SatoshiHatori/rgb_led_controller/docs/requirements.md

# 要求一覧

RGB LED Controller の要求と現在の状態を管理する。最終更新: 2026-11-08

## 運用ルール

- 要求を追加するときは、次の空き番号で行を足す。番号は再利用しない。
- 取り下げた要求や置き換えた要求は消さず、状態を「置換」にして置換先を書く。
- 状態を「完了」にするのは、根拠欄に確認方法を書けるときだけにする。
- 設計上の前提 (`ASM-`) は、確認が取れたら「確認済」にする。要求に昇格する場合は `REQ-` を追加する。

| 状態 | 意味 |
|---|---|
| 完了 | 確認済み |
| 設計完了 | 図面と検証ツールで確認済み。実機は未確認 |
| 進行中 | 一部できているが、満たしていない |
| 置換 | 別の要求に置き換えた |

## 要約

| 状態 | 件数 |
|---|---|
| 完了 | 13 |
| 設計完了 | 13 |
| 進行中 | 4 |
| 置換 | 3 |

## 要求 (REQ)

原文は依頼時の言葉のまま。

| ID | 要求 (原文) | 状態 | 現状と根拠 |
|---|---|---|---|
| REQ-001 | XIAO-RA4M1 を使う | 置換 | REQ-013 で CH32V203K8T6 に置き換え |
| REQ-002 | R/G/B/24V の LED テープを駆動する | 設計完了 | Q2〜Q4、J2。ERC/DRC 違反 0 |
| REQ-003 | 24V からマイコン電源を作る | 設計完了 | Q5 → U4 (5V) → U5 (3.3V)。ERC/DRC 違反 0 |
| REQ-004 | 回路を KiCad で設計する | 完了 | ERC 違反 0 (警告を含む)。A3 に 6 ブロックで配置し、文字とシンボルの重なりを解消 (OPEN-002) |
| REQ-005 | 基板設計する | 完了 | 51 × 42.6mm、2 層。配線済み、DRC 違反 0、未接続 0、回路図との不一致 0 |
| REQ-006 | 3D ビューを出す | 完了 | `hardware/docs/3d_*.png` |
| REQ-007 | 回路図やアートワークなどを README に書く | 完了 | `README.md` に掲載 |
| REQ-008 | 回路の基板設計は別ディレクトリに置く | 完了 | `hardware/` |
| REQ-009 | CAN からの信号で色を変えられるようにする | 設計完了 | 回路とファーム作成済み。PC テスト通過。実機は未確認 |
| REQ-010 | 基板外形はなるべく小さくする | 進行中 | 51 × 42.6mm。Rev A の 115 × 80mm より大幅に小さいが、ロック付き端子と 4 点固定を優先して仮配置の 38 × 31mm より大きくなった (ADR-0004) |
| REQ-011 | 部品は秋月電子通商など日本から購入しやすいものにする | 置換 | REQ-029 で基板の部品は LCSC 品に置き換え (ADR-0007)。電線側の部品は秋月 (`harness_parts.csv`) |
| REQ-012 | 単価を落とす | 進行中 | JLCPCB の実装込みで 5 枚 約 $97 (部品 $31.9、拡張部品の追加料金 $49.1、基本料など $15.8)。基板代と送料は別 (2026-11-07 時点)。追加料金が最大の費目 |
| REQ-013 | 制御マイコンを最小限の安いものにリプレースする | 完了 | CH32V203K8T6 (ADR-0001) |
| REQ-014 | 決定は ADR で記録する | 完了 | `docs/adr/` に 8 本 |
| REQ-015 | PlatformIO から書き込めるようにする (依頼時は質問「platformioから書き込める？」) | 進行中 | `firmware/platformio.ini` はあるが、PlatformIO でのビルドと書き込みは未実行。`make` でのクロスビルドは通過 (1,060 バイト、esp-13.2.0 の riscv32 gcc) |
| REQ-016 | コネクタも小さくする | 置換 | REQ-021 を優先。5A とロックを両立できる小型品がなく、CAN のみ小型の PA にした (ADR-0004) |
| REQ-017 | README の画像なども更新する | 完了 | 最終の基板データから再出力 |
| REQ-018 | 要求をリスト化して管理する | 完了 | この文書 |
| REQ-019 | 3D モデルがないものを作って追加する | 完了 | Q1〜Q4、F1、J1〜J3 を簡易形状で作成。J1〜J3 の寸法と高さは JST カタログ値 (OPEN-005)。JP1 は部品なし |
| REQ-020 | アートワークも設計して発注できる状態まで行く | 設計完了 | ガーバー、ドリル、BOM、座標を出力。JLCPCB の製造能力値でのルールチェックは違反 0。製造元ビューアでの確認と発注は未実施 (OPEN-003) |
| REQ-021 | 移動ロボットで使う。ネジ留めは抜けるので端子を見直す | 設計完了 | J1、J2 を JST VH、J3 を JST PA に変更 (ADR-0004)。実機の振動試験は未実施 |
| REQ-022 | 旧版は消してよい | 完了 | `archive/` を削除 |
| REQ-023 | 取付穴を 4 点固定にする | 完了 | H1〜H4 (M3) を四隅に配置。DRC 違反 0 |
| REQ-024 | モータ駆動回路とは別電源 | 設計完了 | TVS を SMBJ45CA に変更 (ADR-0006)。DRC 違反 0 |
| REQ-025 | CAN 途絶時は消灯する | 設計完了 | 既定 500ms で消灯 (ADR-0005)。PC テスト通過。実機は未確認 |
| REQ-026 | 電源の最大電圧は DC/DC コンバータの 24V 出力 | 設計完了 | 回路の許容範囲 約 13〜45V に収まるので回路変更なし。実機は未確認 |
| REQ-027 | CAN は優先度低めにする (ID の優先度と解釈) | 設計完了 | 既定 ID を 0x100 から 0x7D0 に変更 (ADR-0005)。実機は未確認 |
| REQ-028 | FET を見直す | 設計完了 | Q1〜Q4 を HYG080N10LS1C2 (LCSC 在庫約 14,700 個) に変更 (ADR-0007)。フットプリントはパッケージ図と照合。ERC/DRC 違反 0 |
| REQ-029 | 部品実装まで (JLCPCB に) 頼む | 設計完了 | 全部品を LCSC 品に変更 (ADR-0007)。`jlc_bom.csv`、`jlc_cpl.csv` を出力。発注は未実施 (OPEN-007) |
| REQ-030 | 5 枚くらい作る | 進行中 | 5 枚で見積り (REQ-012)。発注は未実施 |
| REQ-031 | 書き込み端子をつける (依頼時は質問「書き込み端子ついてる？」) | 完了 | J4 (SWD、1.27mm 4 ピン、未実装パッド) が既にある。回路図と基板で確認 |
| REQ-032 | 余っているポートも空いているスペースに出す | 設計完了 | 14 本と +3.3V、GND を J6 (1.27mm 2 × 8、未実装) に出した (ADR-0008)。基板の大きさは変えていない。ERC/DRC 違反 0 |
| REQ-033 | デバッグ用の UART を 1 つ出す | 設計完了 | USART1 の PA9/PA10 を J5 (2.54mm 3 ピン、未実装) に出した (ADR-0008)。ファームは 115200bps 8N1 でデバッグ出力する (OPEN-008)。PC テストとクロスビルドは通過、実機は未確認 |

## 設計上の前提 (ASM)

依頼された要求ではなく、設計時に置いた前提。違っていれば設計が変わる。

| ID | 前提 | 反映先 | 状態 |
|---|---|---|---|
| ASM-001 | 電源は DC/DC コンバータの 24V 出力で、モータ駆動回路とは別系統 | D1, Q1, ADR-0006 | 確認済 |
| ASM-002 | テープは合計 5A のコモンアノード | F1, Q2〜Q4, J1, J2 | 未確認 |
| ASM-003 | 入力電圧の下限は約 13V でよい (入力は 24V 固定) | Q5, ADR-0003 | 確認済 |
| ASM-004 | CAN は 500kbit/s、低優先の 11bit ID 0x7D0、ADR-0005 のフレーム形式。ID の衝突とビットレートはロボット側と未照合 | `firmware/` | 未確認 |
| ASM-005 | CAN 途絶から消灯までの既定時間は 500ms でよい (送信側は 500ms より短い周期で送る) | `firmware/src/color.h` | 未確認 |
| ASM-006 | PWM は 1kHz | `firmware/src/color.h` | 未確認 |
| ASM-007 | この基板が CAN バスの終端でないなら JP1 は開放のまま | R6, JP1 | 未確認 |

## 未解決事項 (OPEN)

| ID | 内容 | 関連 | 優先 |
|---|---|---|---|
| OPEN-001 | TPH4R10ANL を 1 枚に 4 個使うが、秋月の通販在庫は 5 個 (2026-11-07) で 1 枚分しかない。代替か別調達が必要 | REQ-011, 012 | 解決 (ADR-0007 で HYG080N10LS1C2 に変更) |
| OPEN-002 | 回路図の文字やシンボルが重なっている箇所がある。A2 の左上に寄っている | REQ-004 | 解決 (A3 に配置し直し。ネットリストは変更前と一致、ERC/DRC 違反 0、回路図と基板の不一致 0) |
| OPEN-003 | ガーバーを製造元のビューアとルールチェックに通す。基板色を決める (枚数は 5 枚) | REQ-020 | 発注前。残りは JLC のビューアでの確認だけ。基板色は緑に決定 (2026-11-08)。JLCPCB の製造能力値 (2 層 1.6mm: 配線幅と間隔 0.1mm、PTH の環状幅 0.18mm、穴間 0.45mm、PTH と配線 0.28mm、ビアと配線 0.2mm、基板端 0.2mm、シルク文字 高さ 1.0mm / 線幅 0.15mm) を DRC ルールにして照合した。裏面シルクの基板名の線幅 0.14mm を 0.15mm に直して違反 0。実際の最小値は配線幅 0.2mm、間隔 0.363mm、PTH の環状幅 0.2mm (J4)、穴間 0.7mm、基板端 0.8mm。ガーバーを再出力し、変わったのは裏面シルクだけと確認 |
| OPEN-004 | JLCPCB 向けの確認。シルク文字 0.8mm は同社推奨の 1.0mm より小さい。J4 のパッドは環状幅 0.175mm で同社最小の 0.18mm を下回る | REQ-020 | 解決 (シルク 1.0mm、J4 パッド 1.05mm に変更。DRC 違反 0) |
| OPEN-005 | 自作の J3 のフットプリントを現物と照合する (JST カタログ値)。Q1〜Q4、F1 はデータシートの図と照合済み。3D モデルの高さは J1、J2 が推定 | REQ-019, 021 | 解決 (JST PA カタログ p.3、p.6 と照合し、フットプリントの変更は不要。本体 8.0 × 5.3mm、ピッチ 2.0mm、ピン列は本体端から 1.7mm、1 番ピンの位置、高さ 5.9mm が一致。穴径 0.8mm は推奨 φ0.7 +0.1/0 の上限。JLC の仕上がり公差は +0.13/-0.08mm なので、ポストの対角 0.71mm が入らなくなる細い側を避けてこのままにした。J1、J2 の 3D モデルの高さは JST VH カタログ値 (本体 9.4mm、ポスト先端 11.4mm、基板下 3.2mm) に修正。現物との照合は部品の受け取り時に行う) |
| OPEN-006 | 実機確認がすべて未実施 (CAN 受信、PWM、電源、温度、振動)。特に U4 (最大約 0.5W) と Q5 の温度 | REQ-002, 003, 009, 021 | 試作時 |
| OPEN-007 | JLCPCB の発注画面で確認する。基板代と送料の見積り、発注時の在庫、部品配置の回転 (KiCad の座標と JLC で向きが違うことがある) | REQ-029, 030 | 発注時 |
| OPEN-008 | ファームに UART (USART1、PA9/PA10) のデバッグ出力がない。必要なら追加する | REQ-033 | 解決 (PA9 から 115200bps 8N1 で送信のみ。起動時のリセット要因、クロック源、CAN 初期化の結果、色の変化、途絶による消灯、CAN エラー状態の変化を 1 行ずつ出す。送信は待たずにバッファへ積み、取りこぼしは件数を出す。`-DDEBUG_UART=0` で無効にできる。PC テストに `test_dbglog` を追加) |
