SatoshiHatori/rgb_led_controller/docs/adr/0008-io-breakout.md

# ADR-0008: 空きポートとデバッグ用 UART を未実装パッドで出す

状態: 採用 (2026-11-08)

## 背景

- 依頼は、空きポートを基板の空きスペースに出すことと、デバッグ用の UART を 1 つ出すこと。
- CH32V203K8T6 の未使用ピンは 16 本ある (PA3〜PA10、PA15、PB0、PB1、PB3〜PB7)。
- 基板は 51 × 42.6mm でほぼ埋まっている。部品を置ける空きは、J2 と J3 の間 (R7〜R9 の下) の約 11 × 8mm だけ。
- 書き込み端子は既にある (J4: SWD、1.27mm 4 ピン、未実装)。

## 決定

- **UART:** USART1 の既定ピン (PA9 = TX、PA10 = RX) を使い、J5 に出す。
  - 2.54mm ピッチ 1 × 3 (1 = TX、2 = RX、3 = GND)。USB シリアル変換器のジャンパ線をそのまま挿せる。
  - PA9/PA10 は WCH の UART 書き込み (ISP) に使うピンでもある。
- **空きポート:** 残り 14 本と +3.3V、GND を J6 に出す。
  - 1.27mm ピッチ 2 × 8。空きに収まるのはこの大きさまで。
  - パッドは J4 と同じく 1.05mm。JLCPCB の最小環状幅 0.18mm を満たす。
- **ピンの並び:** 配線経路に合わせて決めた。

  | J6 | 信号 | J6 | 信号 |
  |---|---|---|---|
  | 1 | GND | 2 | PB7 |
  | 3 | +3.3V | 4 | PB6 |
  | 5 | PB1 | 6 | PB5 |
  | 7 | PB0 | 8 | PA3 |
  | 9 | PA8 | 10 | PA4 |
  | 11 | PA15 | 12 | PA5 |
  | 13 | PB3 | 14 | PA6 |
  | 15 | PB4 | 16 | PA7 |

- J5、J6 は J4 と同じく未実装 (DNP) にし、JLC の実装対象から外す。使うときにピンヘッダを手はんだする。
- **既存配線の変更:** CAN_RXD は U1 の内側にあったビアと裏面の配線を上へ移した。PA8〜PA10 の引き出し口を空けるため。変えた既存配線はこれだけ。
- **配線方法:** 手で座標を決めて引いた。Freerouting (v2.1.0) も試したが、空きが狭く 6〜10 本が未配線で残った。

## 結果

- 部品代と実装費は変わらない (未実装のため)。
- U1 の下と J6 まわりの GND ゾーン (表面・裏面とも) は信号線で細切れになる。いずれも低速の GPIO なので許容した。
- U1 の 16 番 (VSS) の GND ビアは、配線を避けて位置を移した。
- GND のステッチングビアを 8 個外した。
- 基板の大きさは変えていない (REQ-010)。
- 裏面シルクに「J5」「J6」、J5 のピン名「TX RX G」、J6 の 1 番ピンの印を入れた。表面には文字を置く余地がない。
- ファームウェアは空きピンをプルアップ入力にしたまま。UART は PA9 からデバッグ出力を送る (115200bps 8N1、送信のみ。2026-11-08 追加)。PA10 はプルアップ入力のまま。
