SatoshiHatori/rgb_led_controller/docs/adr/0004-connectors.md

# ADR-0004: 端子は JST VH と JST PA にする

状態: 採用 (2026-11-07)

## 背景

基板は移動ロボットに載せる。ネジ留め端子は振動で抜けるため使えない。コネクタの小型化も求められているが、電源と LED には合計 5A を流す想定がある。

## 検討

| 候補 | ピッチ | 定格 (1 ピン) | ロック | 判断 |
|---|---|---|---|---|
| ネジ端子 WJEK254 | 2.54mm | 未確認 | なし | ネジが緩むので不採用 |
| JST PA | 2.0mm | 3A (AWG22 時) | あり | 5A に足りず、電源と LED には不採用 |
| JST VH | 3.96mm | 10A | あり | 電源と LED に採用 |

## 決定

- J1 (電源): JST B2P-VH
- J2 (LED): JST B4P-VH
- J3 (CAN): JST B03B-PASK

いずれも秋月で購入できる。JLCPCB の実装では同じ JST 純正品を LCSC から使う (ADR-0007)。J3 は小電流なので小さい PA にした。

## 結果

- 振動対策のロックで抜けにくくなる。
- 電線を圧着する必要があり、圧着工具が要る。
- コネクタの高さと面積が増え、基板は仮配置の 38 × 31mm から大きくなった (四隅の取付穴を含めて 51 × 42.6mm)。小型化より抜け防止を優先した。
- 秋月の SVH-21T-P1.1 の適用電線は AWG22〜18。5A には AWG18 を使う。
