SatoshiHatori/rgb_led_controller/hardware/fabrication/bom.csv

Reference | Value | Footprint | MPN | Vendor | Code | Qty | DNP
C1 | 10uF 100V | Capacitor_SMD:C_1210_3225Metric | Murata GRM32EC72A106KE05L | LCSC | C576517 | 1
C2 | 0.1uF 100V | Capacitor_SMD:C_0603_1608Metric | Samsung CL10B104KC8NNNC | LCSC | C15725 | 1
C3,C4,C5 | 1uF 50V | Capacitor_SMD:C_0603_1608Metric | Samsung CL10A105KB8NNNC | LCSC | C15849 | 3
C6,C7,C8,C9,C12,C13,C14 | 0.1uF | Capacitor_SMD:C_0603_1608Metric | YAGEO CC0603KRX7R9BB104 | LCSC | C14663 | 7
C10,C11 | 15pF | Capacitor_SMD:C_0603_1608Metric | Samsung CL10C150JB8NNNC | LCSC | C1644 | 2
D1 | SMBJ45CA | Diode_SMD:D_SMB | SMBJ45CA | LCSC | C114006 | 1
D2,D3 | BZT52C15S | Diode_SMD:D_SOD-323 | BZT52C15S | LCSC | C173448 | 2
F1 | 10A 125V | vsi:Fuse_Littelfuse_NANO2_2410 | Littelfuse 0451010.MRL | LCSC | C44479 | 1
J1 | BATT_24V | Connector_JST:JST_VH_B2P-VH_1x02_P3.96mm_Vertical | JST B2P-VH(LF)(SN) | LCSC | C160315 | 1
J2 | LED_TAPE (24V/R/G/B) | Connector_JST:JST_VH_B4P-VH_1x04_P3.96mm_Vertical | JST B4P-VH(LF)(SN) | LCSC | C160317 | 1
J3 | CAN | vsi:JST_PA_B03B-PASK | JST B03B-PASK(LF)(SN) | LCSC | C158048 | 1
J4 | SWD | vsi:PinHeader_1x04_P1.27mm_Vertical_Pad1.05 | (未実装) | - |  | 1 | DNP
J5 | UART | Connector_PinHeader_2.54mm:PinHeader_1x03_P2.54mm_Vertical | (未実装) | - |  | 1 | DNP
J6 | GPIO | vsi:PinHeader_2x08_P1.27mm_Vertical_Pad1.05 | (未実装) | - |  | 1 | DNP
JP1 | TERM | Jumper:SolderJumper-2_P1.3mm_Open_Pad1.0x1.5mm | (はんだブリッジ) | - |  | 1 | DNP
Q1,Q2,Q3,Q4 | HYG080N10LS1C2 | vsi:PDFN-8_5x6mm_P1.27mm | HUAYI HYG080N10LS1C2 | LCSC | C3011225 | 4
Q5 | IRFR3910 | Package_TO_SOT_SMD:TO-252-2 | Infineon IRFR3910TRPBF | LCSC | C148158 | 1
R1,R2,R3,R4,R7,R8,R9,R13,R14,R15 | 100k | Resistor_SMD:R_0603_1608Metric | UNI-ROYAL 0603WAF1003T5E | LCSC | C25803 | 10
R5 | 10k | Resistor_SMD:R_0603_1608Metric | UNI-ROYAL 0603WAF1002T5E | LCSC | C25804 | 1
R6 | 120 | Resistor_SMD:R_0603_1608Metric | UNI-ROYAL 0603WAF1200T5E | LCSC | C22787 | 1
R10,R11,R12 | 470 | Resistor_SMD:R_0603_1608Metric | UNI-ROYAL 0603WAF4700T5E | LCSC | C23179 | 3
U1 | CH32V203K8T6 | Package_QFP:LQFP-32_7x7mm_P0.8mm | WCH CH32V203K8T6 | LCSC | C5372188 | 1
U2 | ATA6561 | Package_SO:SOIC-8_3.9x4.9mm_P1.27mm | Microchip ATA6561-GAQW-N | LCSC | C616016 | 1
U3 | 74VHCT04AFT | Package_SO:TSSOP-14_4.4x5mm_P0.65mm | Toshiba 74VHCT04AFT | LCSC | C5381636 | 1
U4 | CJ78L05 | Package_TO_SOT_SMD:SOT-89-3 | JCET CJ78L05 (SOT-89) | LCSC | C2079 | 1
U5 | AP7333-33SAG | Package_TO_SOT_SMD:SOT-23 | Diodes AP7333-33SAG-7 | LCSC | C150746 | 1
Y1 | 8MHz 10pF | Crystal:Crystal_SMD_3225-4Pin_3.2x2.5mm | YXC TAXM8M4RDBCCT2T | LCSC | C400090 | 1
