SatoshiHatori/rgb_led_controller/hardware/fabrication/harness_parts.csv

Item | Part | Vendor | Code | Qty per board | Note
J1 housing | JST VHR-2N | 秋月 | 112811 | 1 | 24V battery
J2 housing | JST VHR-4N | 秋月 | 112813 | 1 | LED tape
J1/J2 contact | JST SVH-21T-P1.1 | 秋月 | 112819 | 6 | Pack of 10
J3 housing | JST PAP-03V-S | 秋月 | 115008 | 1 | CAN
J3 contact | JST SPHD-002T-P0.5 | 秋月 | 114424 | 3 | Pack of 10
