SatoshiHatori/rgb_led_controller/hardware/rgb_led_controller.kicad_pcb

## KiCad design hardware/rgb_led_controller.kicad_pcb (2026-11-07)

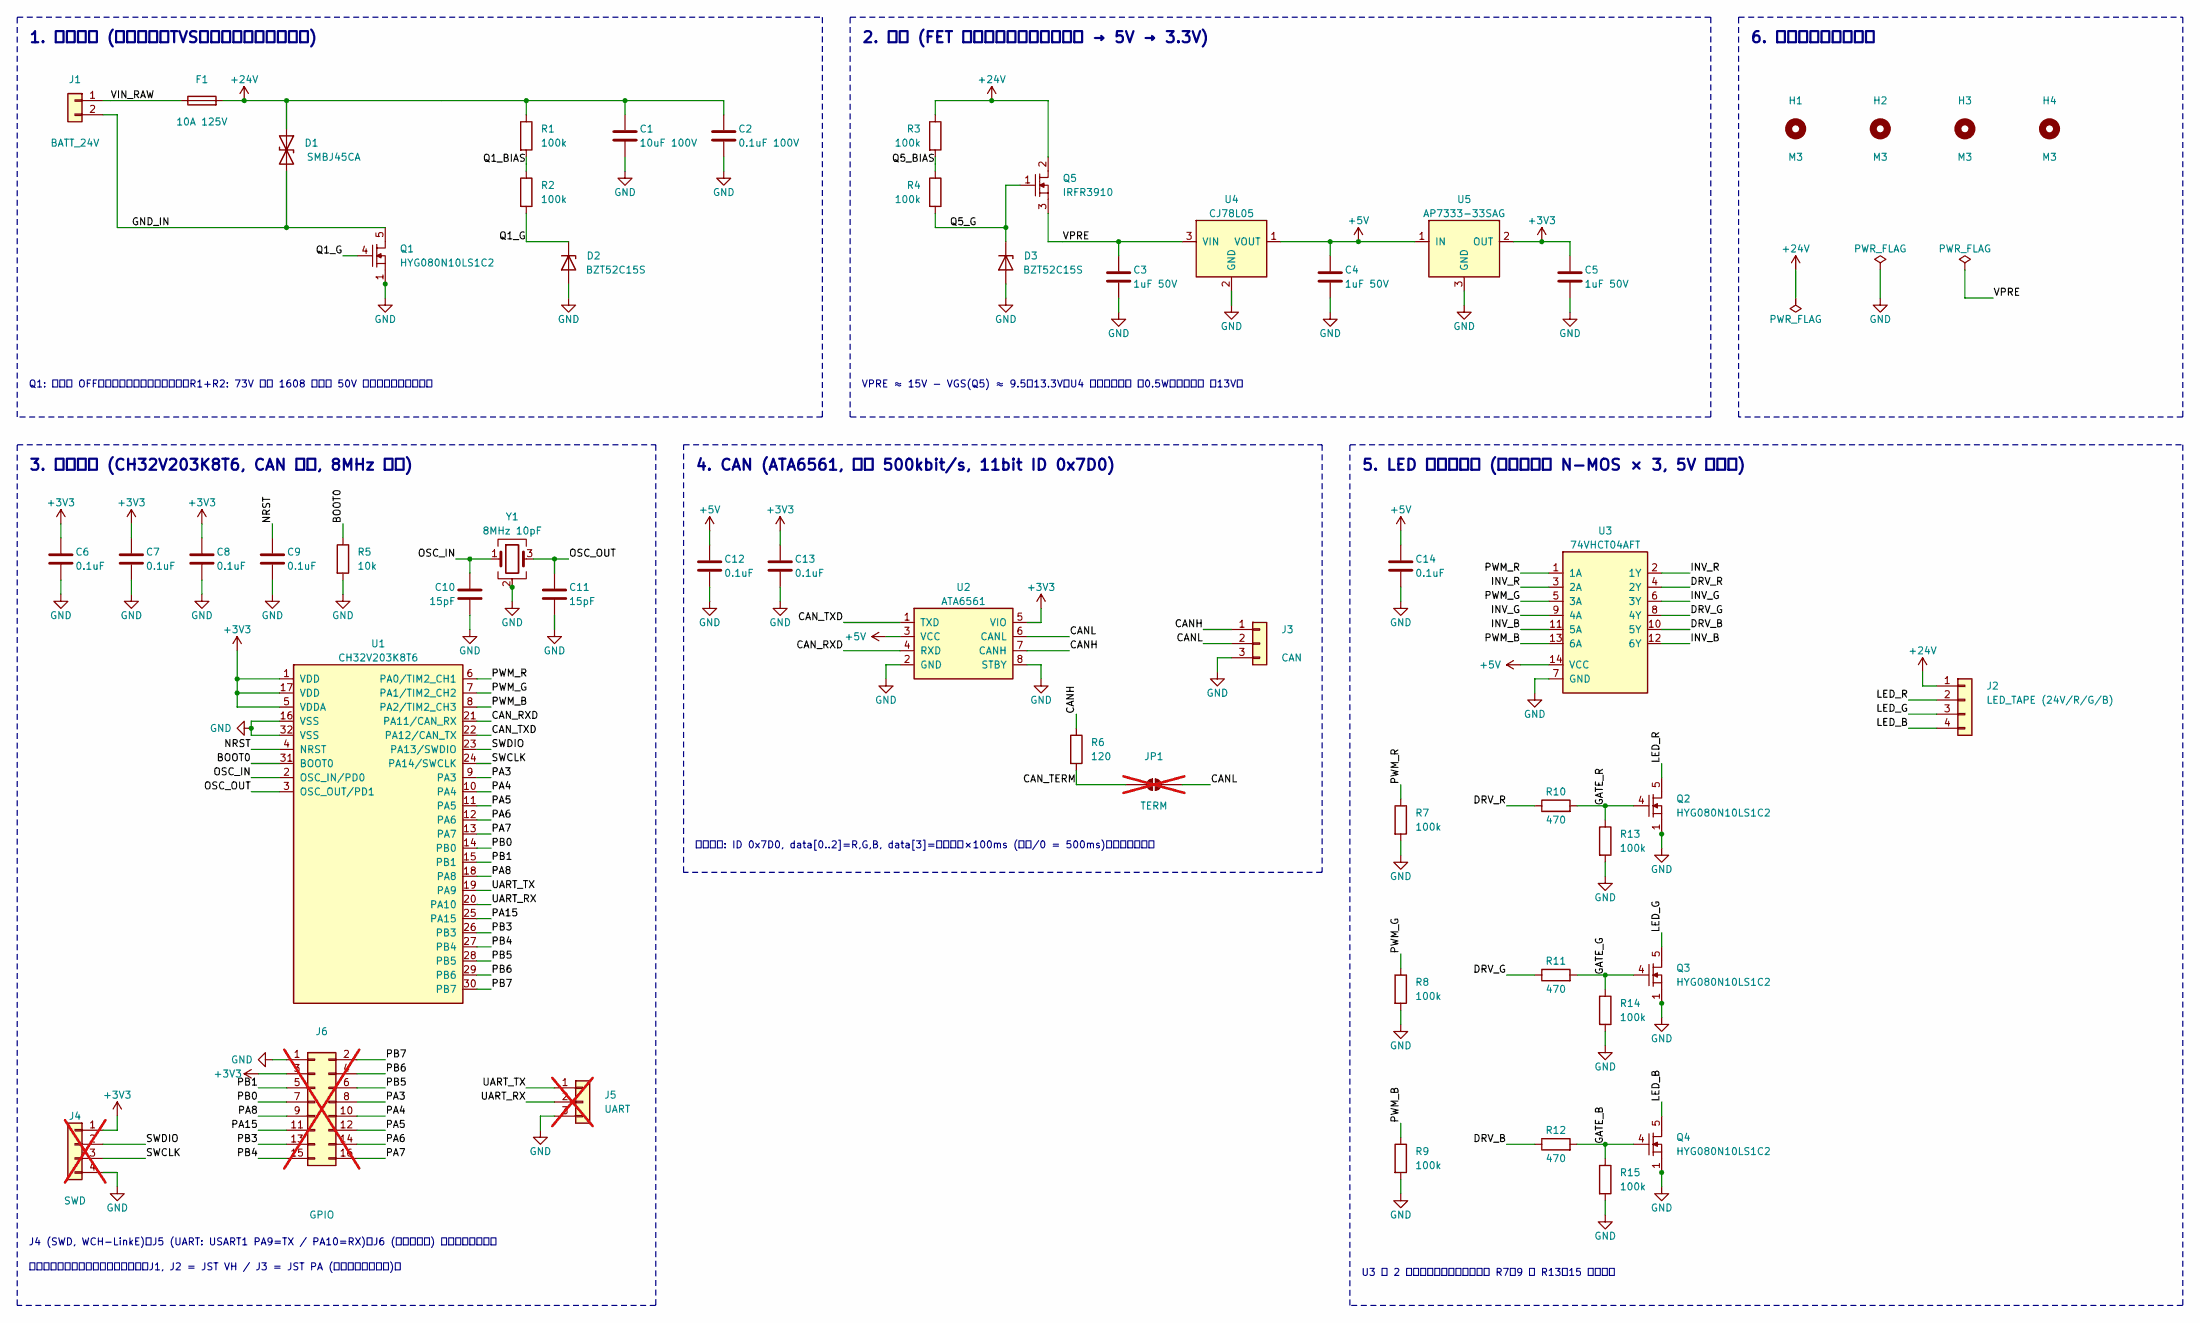
[picture p11: schematic rgb_led_controller.kicad_sch, RGB LED Controller - CH32V203 / CAN / 24V RGB LED]

Parts:
C1: 10uF 100V; C_1210_3225Metric; MPN Murata GRM32EC72A106KE05L
C2: 0.1uF 100V; C_0603_1608Metric; MPN Samsung CL10B104KC8NNNC
C3, C4, C5: 1uF 50V; C_0603_1608Metric; MPN Samsung CL10A105KB8NNNC
C6, C7, C8, C9, C12, C13, C14: 0.1uF; C_0603_1608Metric; MPN YAGEO CC0603KRX7R9BB104
C10, C11: 15pF; C_0603_1608Metric; MPN Samsung CL10C150JB8NNNC
D1: SMBJ45CA; D_SMB; MPN SMBJ45CA
D2, D3: BZT52C15S; D_SOD-323; MPN BZT52C15S
F1: 10A 125V; Fuse_Littelfuse_NANO2_2410; MPN Littelfuse 0451010.MRL
H1, H2, H3, H4: M3; MountingHole_3.2mm_M3
J1: BATT_24V; JST_VH_B2P-VH_1x02_P3.96mm_Vertical; MPN JST B2P-VH(LF)(SN)
J2: LED_TAPE (24V/R/G/B); JST_VH_B4P-VH_1x04_P3.96mm_Vertical; MPN JST B4P-VH(LF)(SN)
J3: CAN; JST_PA_B03B-PASK; MPN JST B03B-PASK(LF)(SN)
J4: SWD; PinHeader_1x04_P1.27mm_Vertical_Pad1.05; MPN (未実装); not fitted
J5: UART; PinHeader_1x03_P2.54mm_Vertical; MPN (未実装); not fitted
J6: GPIO; PinHeader_2x08_P1.27mm_Vertical_Pad1.05; MPN (未実装); not fitted
JP1: TERM; SolderJumper-2_P1.3mm_Open_Pad1.0x1.5mm; MPN (はんだブリッジ); not fitted
Q1, Q2, Q3, Q4: HYG080N10LS1C2; PDFN-8_5x6mm_P1.27mm; MPN HUAYI HYG080N10LS1C2
Q5: IRFR3910; TO-252-2; MPN Infineon IRFR3910TRPBF
R1, R2, R3, R4, R7, R8, R9, R13, R14, R15: 100k; R_0603_1608Metric; MPN UNI-ROYAL 0603WAF1003T5E
R5: 10k; R_0603_1608Metric; MPN UNI-ROYAL 0603WAF1002T5E
R6: 120; R_0603_1608Metric; MPN UNI-ROYAL 0603WAF1200T5E
R10, R11, R12: 470; R_0603_1608Metric; MPN UNI-ROYAL 0603WAF4700T5E
U1: CH32V203K8T6; LQFP-32_7x7mm_P0.8mm; MPN WCH CH32V203K8T6
U2: ATA6561; SOIC-8_3.9x4.9mm_P1.27mm; MPN Microchip ATA6561-GAQW-N
U3: 74VHCT04AFT; TSSOP-14_4.4x5mm_P0.65mm; MPN Toshiba 74VHCT04AFT
U4: CJ78L05; SOT-89-3; MPN JCET CJ78L05 (SOT-89)
U5: AP7333-33SAG; SOT-23; MPN Diodes AP7333-33SAG-7
Y1: 8MHz 10pF; Crystal_SMD_3225-4Pin_3.2x2.5mm; MPN YXC TAXM8M4RDBCCT2T

Connections:
+3V3: C5.1, C6.1, C7.1, C8.1, C13.1, J4.1, J6.3, U1.1 (VDD), U1.5 (VDDA), U1.17 (VDD), U2.5 (VIO), U5.2 (OUT)
+5V: C4.1, C12.1, C14.1, U2.3 (VCC), U3.14 (VCC), U4.1 (VOUT), U5.1 (IN)
+24V: C1.1, C2.1, D1.1 (A1), F1.2, J2.1, Q5.2 (D), R1.1, R3.1
/BOOT0: R5.1, U1.31 (BOOT0)
/CANH: J3.1, R6.1, U2.7 (CANH)
/CANL: J3.2, JP1.2 (B), U2.6 (CANL)
/CAN_RXD: U1.21 (PA11/CAN_RX), U2.4 (RXD)
/CAN_TERM: JP1.1 (A), R6.2
/CAN_TXD: U1.22 (PA12/CAN_TX), U2.1 (TXD)
/DRV_B: R12.1, U3.10 (5Y)
/DRV_G: R11.1, U3.8 (4Y)
/DRV_R: R10.1, U3.4 (2Y)
/GATE_B: Q4.4 (G), R12.2, R15.1
/GATE_G: Q3.4 (G), R11.2, R14.1
/GATE_R: Q2.4 (G), R10.2, R13.1
/GND_IN: D1.2 (A2), J1.2, Q1.5 (D)
/INV_B: U3.11 (5A), U3.12 (6Y)
/INV_G: U3.6 (3Y), U3.9 (4A)
/INV_R: U3.2 (1Y), U3.3 (2A)
/LED_B: J2.4, Q4.5 (D)
/LED_G: J2.3, Q3.5 (D)
/LED_R: J2.2, Q2.5 (D)
/NRST: C9.1, U1.4 (NRST)
/OSC_IN: C10.1, U1.2 (OSC_IN/PD0), Y1.1
/OSC_OUT: C11.1, U1.3 (OSC_OUT/PD1), Y1.3
/PA3: J6.8, U1.9 (PA3)
/PA4: J6.10, U1.10 (PA4)
/PA5: J6.12, U1.11 (PA5)
/PA6: J6.14, U1.12 (PA6)
/PA7: J6.16, U1.13 (PA7)
/PA8: J6.9, U1.18 (PA8)
/PA15: J6.11, U1.25 (PA15)
/PB0: J6.7, U1.14 (PB0)
/PB1: J6.5, U1.15 (PB1)
/PB3: J6.13, U1.26 (PB3)
/PB4: J6.15, U1.27 (PB4)
/PB5: J6.6, U1.28 (PB5)
/PB6: J6.4, U1.29 (PB6)
/PB7: J6.2, U1.30 (PB7)
/PWM_B: R9.1, U1.8 (PA2/TIM2_CH3), U3.13 (6A)
/PWM_G: R8.1, U1.7 (PA1/TIM2_CH2), U3.5 (3A)
/PWM_R: R7.1, U1.6 (PA0/TIM2_CH1), U3.1 (1A)
/Q1_BIAS: R1.2, R2.1
/Q1_G: D2.1 (K), Q1.4 (G), R2.2
/Q5_BIAS: R3.2, R4.1
/Q5_G: D3.1 (K), Q5.1 (G), R4.2
/SWCLK: J4.3, U1.24 (PA14/SWCLK)
/SWDIO: J4.2, U1.23 (PA13/SWDIO)
/UART_RX: J5.2, U1.20 (PA10)
/UART_TX: J5.1, U1.19 (PA9)
/VIN_RAW: F1.1, J1.1
/VPRE: C3.1, Q5.3 (S), U4.3 (VIN)
GND: C1.2, C2.2, C3.2, C4.2, C5.2, C6.2, C7.2, C8.2, C9.2, C10.2, C11.2, C12.2, C13.2, C14.2, D2.2 (A), D3.2 (A), J3.3, J4.4, J5.3, J6.1, Q1.1 (S), Q1.2 (S), Q1.3 (S), Q2.1 (S), Q2.2 (S), Q2.3 (S), Q3.1 (S), Q3.2 (S), Q3.3 (S), Q4.1 (S), Q4.2 (S), Q4.3 (S), R5.2, R7.2, R8.2, R9.2, R13.2, R14.2, R15.2, U1.16 (VSS), U1.32 (VSS), U2.2 (GND), U2.8 (STBY), U3.7 (GND), U4.2 (GND), U5.3 (GND), Y1.2 (G), Y1.4 (G)

Notes on the sheet:
1. 入力保護 (ヒューズ・TVS・ローサイド逆接保護)
Q1: 逆接時 OFF、ボディダイオードが阻止。R1+R2: 73V 時に 1608 の定格 50V を超えないよう直列。
2. 電源 (FET リニアプリレギュレータ → 5V → 3.3V)
VPRE ≈ 15V − VGS(Q5) ≈ 9.5〜13.3V。U4 の損失は最大 約0.5W。入力下限 約13V。
6. 取付穴・電源フラグ
3. マイコン (CH32V203K8T6, CAN 内蔵, 8MHz 水晶)
J4 (SWD, WCH-LinkE)、J5 (UART: USART1 PA9=TX / PA10=RX)、J6 (空きポート) は未実装パッド。
未使用ピンはプルアップ入力に設定。J1, J2 = JST VH / J3 = JST PA (ロック付、耐振動)。
4. CAN (ATA6561, 既定 500kbit/s, 11bit ID 0x7D0)
フレーム: ID 0x7D0, data[0..2]=R,G,B, data[3]=保持時間×100ms (省略/0 = 500ms)。途絶で消灯。
5. LED テープ駆動 (ローサイド N-MOS × 3, 5V ゲート)
U3 は 2 段直列で非反転。起動中は R7〜9 と R13〜15 で消灯。

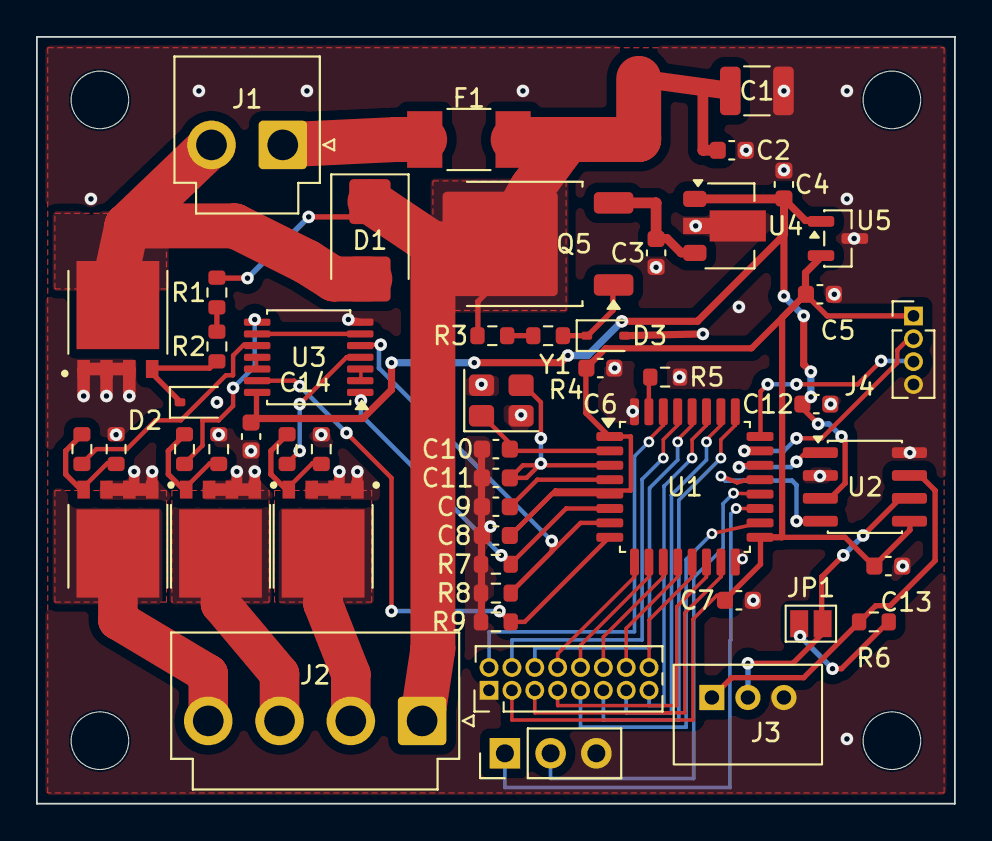
[picture p12: board rgb_led_controller.kicad_pcb from above]

Board: 2 copper layers, 51.0 x 42.6 mm, 55 parts (0 on the bottom side), 53 nets.
