SatoshiHatori/rgb_led_controller/(commit log)

2026-11-07 Add Rev B KiCad project and JLCPCB fabrication data
    Schematic, PCB, project libraries, gerbers, BOM/CPL and rendered images.
    [bom.csv, harness_parts.csv, jlc_bom.csv, positions.csv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]
2026-11-07 Set JST VH 3D model heights to catalog values
    J1/J2 models were 1.6 mm too tall. Use body 9.4 mm, post tip 11.4 mm,
    tail 3.2 mm from the JST VH catalog. J3 footprint checked against the
    JST PA catalog and needs no change (OPEN-005).
2026-11-07 Widen back silkscreen title stroke to JLCPCB minimum
    Stroke 0.14 mm -> 0.15 mm. Board passes DRC with JLCPCB 2-layer
    capability rules. Regenerated gerbers; only B_Silkscreen changed.
    [rgb_led_controller.kicad_pcb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]
2026-11-07 Add non-blocking USART1 debug log output
    PA9 at 115200 8N1, transmit only. Logs boot info, color changes,
    timeout off, CAN error state changes and dropped bytes. Disable with
    -DDEBUG_UART=0. Add host test for the log buffer (OPEN-008).
    [dbglog.c, dbglog.h, main.c]
